Maniak003/HV-voltmeter/README.md

<!DOCTYPE html>
<html lang="en" data-color-mode="auto" data-light-theme="light" data-dark-theme="dark">
  <head>
    <meta charset="utf-8">
  </head>
    <body class="logged-in env-production page-responsive page-blob" style="word-wrap: break-word;">
      <p> Hight voltage (3kV) voltrmeter. </p>
      <a href="https://github.com/Maniak003/HVoltmeter/wiki" rel="nofollow">
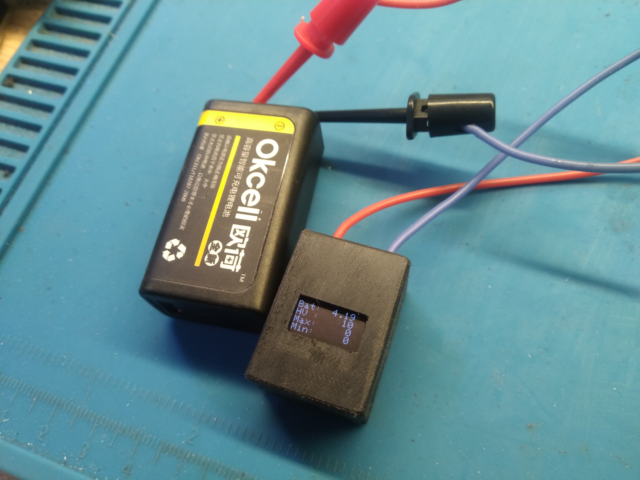
[picture p1: Documents/IMG_20221002_154138.jpg]
        
      </a>
      <a href="https://github.com/Maniak003/HVoltmeter/wiki" rel="nofollow">
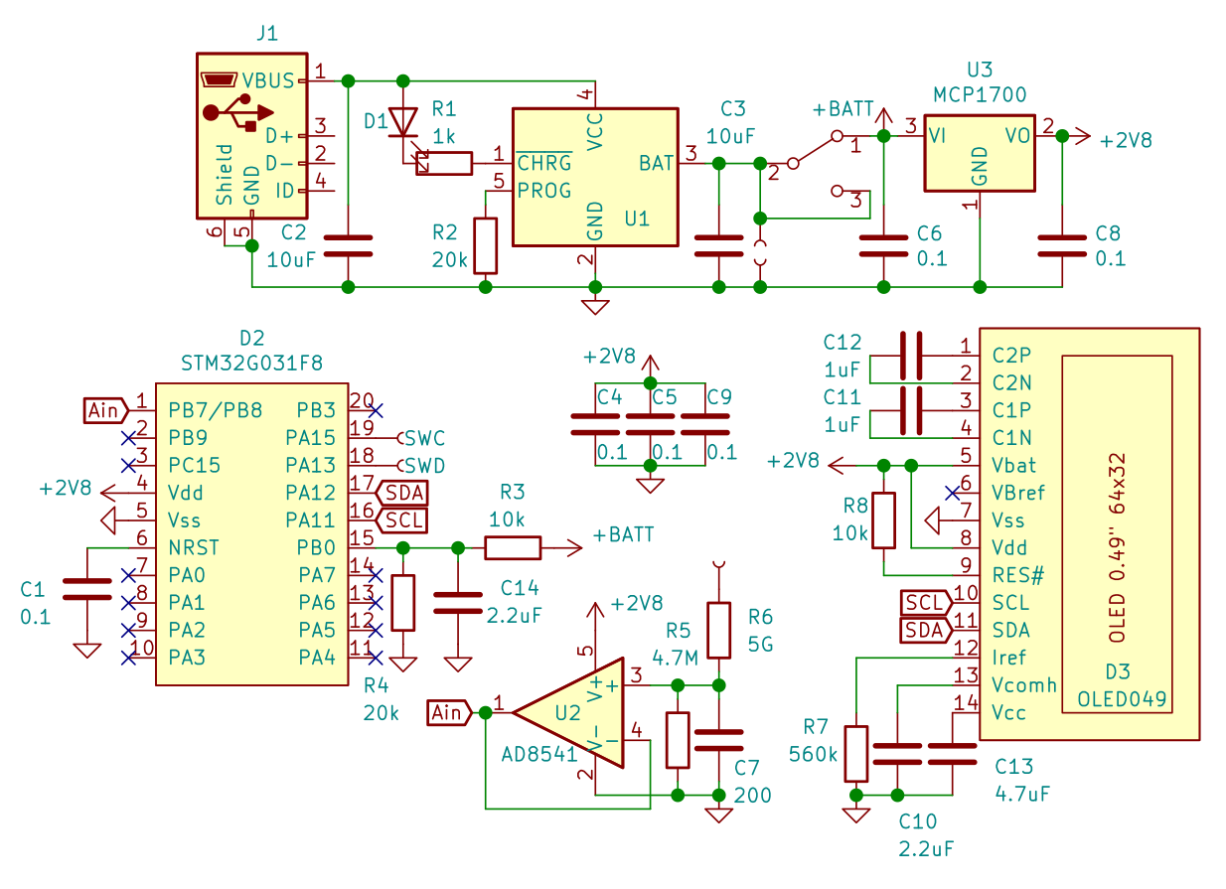
[picture p2: Documents/hvoltmeter.png]
HVoltmeter
        
      </a>
    </body>
</html>
