Maniak003/HV-voltmeter/kicad/hvoltmeter/hvoltmeter.kicad_pcb

## KiCad design kicad/hvoltmeter/hvoltmeter.kicad_pcb (2022-09-29)

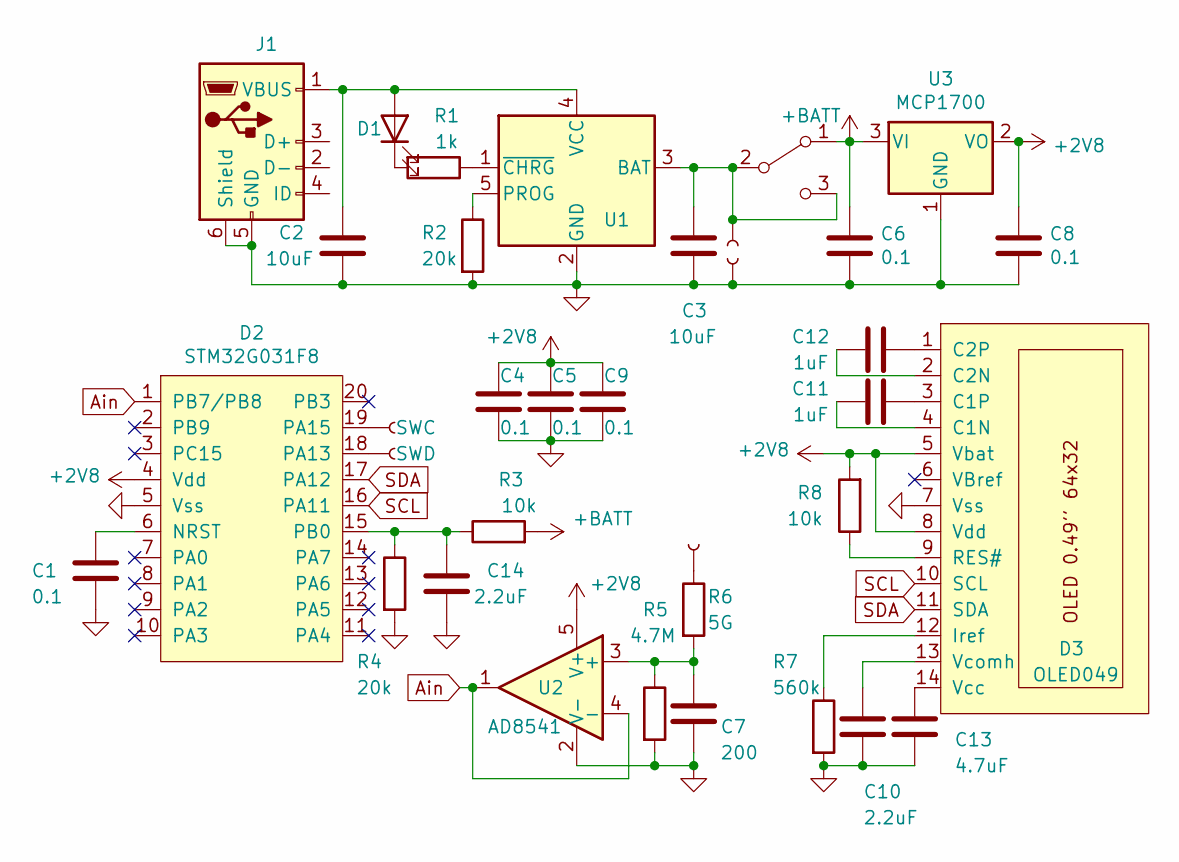
[picture p3: schematic hvoltmeter.sch]

Parts:
C1, C4, C5, C6, C8: 0.1; C_0603_1608Metric
C2, C3: 10uF; C_0603_1608Metric
C7: 200; C_0603_1608Metric
C9: 0.1; C_0402_1005Metric
C10, C14: 2.2uF; C_0402_1005Metric
C11, C12: 1uF; C_0402_1005Metric
C13: 4.7uF; C_0402_1005Metric
D1: LED; LED_0603_1608Metric
D2: STM32G031F8; TSSOP-20_4.4x6.5mm_P0.65mm
D3: OLED049
J1: USB_B_Micro-Connector; USB_Micro-B_Molex_47346-0001
J2: SWC; SMD-CONN
J3: SWD; SMD-CONN
J4, J5, J6: Conn; SMD-CONN
R1: 1k; R_0603_1608Metric
R2, R4: 20k; R_0402_1005Metric
R3, R8: 10k; R_0402_1005Metric
R5: 4.7M; R_0603_1608Metric
R6: 5G; R_2512_6332Metric
R7: 560k; R_0402_1005Metric
SW1: SW_DPDT_x2; MySwithc
U1: LTC4054ES5-4.2; TSOT-23-5
U2: AD8541; TSOT-23-5
U3: MCP1700; SOT-23

Connections:
+2V8: C4.1, C5.1, C8.1, C9.1, D2.4 (Vdd), D3.5 (Vbat), D3.8 (Vdd), R8.2, U2.5 (V+), U3.2 (VO)
+BATT: C6.1, R3.2, SW1.1 (A), U3.3 (VI)
Ain: D2.1 (PB7/PB8), U2.1, U2.4 (-)
GND: C1.2, C2.2, C3.2, C4.2, C5.2, C6.2, C7.2, C8.2, C9.2, C10.1, C13.1, C14.1, D2.5 (Vss), D3.7 (Vss), J1.5 (GND), J1.6 (Shield), J5.1, R2.2, R4.2, R5.2, R7.2, U1.2 (GND), U2.2 (V-), U3.1 (GND)
unnamed: C1.1, D2.6 (NRST)
unnamed: C2.1, D1.2 (A), J1.1 (VBUS), U1.4 (VCC)
unnamed: C3.1, J4.1, SW1.2 (B), SW1.3 (C), U1.3 (BAT)
unnamed: C7.1, R5.1, R6.2, U2.3 (+)
unnamed: C10.2, D3.13 (Vcomh)
unnamed: C11.1, D3.1 (C2P)
unnamed: C11.2, D3.2 (C2N)
unnamed: C12.1, D3.3 (C1P)
unnamed: C12.2, D3.4 (C1N)
unnamed: C13.2, D3.14 (Vcc)
unnamed: C14.2, D2.15 (PB0), R3.1, R4.1
unnamed: D1.1 (K), R1.2
unnamed: D2.18 (PA13), J3.1
unnamed: D2.19 (PA15), J2.1
unnamed: D3.9 (RES#), R8.1
unnamed: D3.12 (Iref), R7.1
unnamed: J6.1, R6.1
unnamed: R1.1, U1.1 (~CHRG)
unnamed: R2.1, U1.5 (PROG)
SCL: D2.16 (PA11), D3.10 (SCL)
SDA: D2.17 (PA12), D3.11 (SDA)

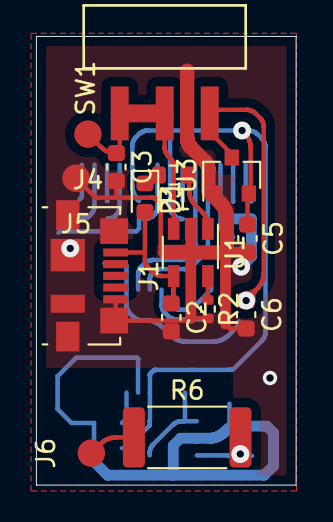
[picture p4: board hvoltmeter.kicad_pcb from above]

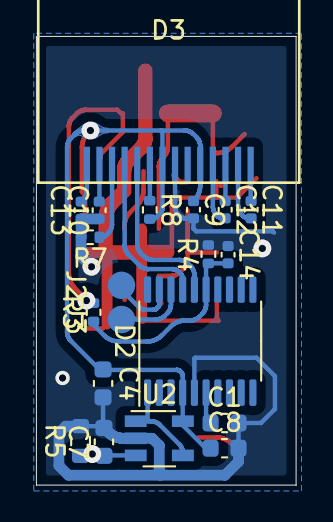
[picture p5: board hvoltmeter.kicad_pcb from below]

Board: 2 copper layers, 14.4 x 24.9 mm, 35 parts (20 on the bottom side), 25 nets.
