Maniak003/HV-voltmeter/STM32Cube/Core/Src/main.c

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
/* Includes ------------------------------------------------------------------*/
#include "main.h"

/* USER CODE BEGIN PM */
char text1306[11];
/* USER CODE END PM */

ADC_HandleTypeDef hadc1;
DMA_HandleTypeDef hdma_adc1;

I2C_HandleTypeDef hi2c2;

TIM_HandleTypeDef htim16;

void SystemClock_Config(void);
static void MX_GPIO_Init(void);
static void MX_DMA_Init(void);
static void MX_I2C2_Init(void);
static void MX_TIM16_Init(void);
static void MX_ADC1_Init(void);
/**
  * @brief  The application entry point.
  * @retval int
  */
int main(void)
{
  /* MCU Configuration--------------------------------------------------------*/

  /* Reset of all peripherals, Initializes the Flash interface and the Systick. */
  HAL_Init();

  /* Configure the system clock */
  SystemClock_Config();

  /* Initialize all configured peripherals */
  MX_GPIO_Init();
  MX_DMA_Init();
  MX_I2C2_Init();
  MX_TIM16_Init();
  MX_ADC1_Init();
  /* USER CODE BEGIN 2 */
  /* ssd1306 init*/
  ssd1306_Init();
  HV = 0;
  LV = 0;
  HAL_TIM_Base_Start_IT(&htim16);
  /* USER CODE END 2 */

  /* Infinite loop */
  /* USER CODE BEGIN WHILE */
  while (1)
  {
	  ssd1306_Fill(Black);
	  ssd1306_SetCursor(0, 0);
	  sprintf(text1306, "Bat:%6.3f", LV);
	  ssd1306_WriteString(text1306, Font_6x8, White);
	  ssd1306_SetCursor(0, 8);
	  sprintf(text1306, "HV : %5.0f", HV);
	  ssd1306_WriteString(text1306, Font_6x8, White);
	  ssd1306_SetCursor(0, 16);
	  sprintf(text1306, "Max: %5.0f", HVmax);
	  ssd1306_WriteString(text1306, Font_6x8, White);
	  ssd1306_SetCursor(0, 24);
	  sprintf(text1306, "Min: %5.0f", HVmin);
	  ssd1306_WriteString(text1306, Font_6x8, White);
	  ssd1306_UpdateScreen();
	  HAL_Delay(100);
    /* USER CODE END WHILE */

    /* USER CODE BEGIN 3 */
  }
  /* USER CODE END 3 */
}

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
/* USER CODE BEGIN 4 */
/*
//void HAL_ADC_ConvCpltCallback(ADC_HandleTypeDef *AdcHandle) {
//void HAL_ADC_ConvHalfCpltCallback(ADC_HandleTypeDef* hadc) {
//void ADC_DMAConvCplt(DMA_HandleTypeDef *hdma) {
	HAL_ADC_Stop_DMA(&hadc1);
	HVolts.HVolt = adcBufer[0];
	LVolts.LVolt = adcBufer[1];
	HVmin++;

}
*/
/* USER CODE END 4 */
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
