Maniak003/HV-voltmeter/STM32Cube/HVoltmeter.ioc

Mcu.UserName=STM32G031F8Px
PB0.GPIO_Label=Batt
PB7.Signal=ADC1_IN11
PB7.GPIO_Label=AIn
PB0.Signal=ADC1_IN8
