Maniak003/HV-voltmeter/STM32Cube/Core/Inc/main.h

#define AIn_Pin GPIO_PIN_7
#define AIn_GPIO_Port GPIOB
#define Batt_Pin GPIO_PIN_0
#define Batt_GPIO_Port GPIOB
