Maniak003/HV-voltmeter/(commit log)

2022-09-23 новый файл: Documents/ER-OLED0.49-1_Series_Datasheet.pdf новый файл: STM32Cube/HV/.cproject новый файл: STM32Cube/HV/.mxproject новый файл: STM32Cube/HV/.project новый файл: STM32Cube/HV/.settings/la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
    [hvoltmeter.kicad_pcb, hvoltmeter.sch]
2022-09-25 удалено: STM32Cube/HV/.cproject удалено: STM32Cube/HV/.mxproject удалено: STM32Cube/HV/.project удалено: STM32Cube/HV/.settings/language.settings.xml удалено: STM32Cube/HV/.settings/stm32cubeide.proj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
    [hvoltmeter.kicad_pcb, hvoltmeter.sch]
2022-09-25 новый файл: STM32Cube/.cproject новый файл: STM32Cube/.mxproject новый файл: STM32Cube/.project новый файл: STM32Cube/.settings/language.settings.xml новый файл: STM32Cube/.settings/stm32cubeide.proj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
2022-09-25 изменено: STM32Cube/.cproject новый файл: STM32Cube/Release/Core/Src/main.d новый файл: STM32Cube/Release/Core/Src/main.o новый файл: STM32Cube/Release/Core/Src/main.su новый файл: STM32Cube/Release/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
2022-09-25 новый файл: kicad/hvoltmeter/hvoltmeter-rescue.dcm новый файл: kicad/hvoltmeter/hvoltmeter-rescue.lib новый файл: kicad/hvoltmeter/sym-lib-table
2022-09-26 изменено: kicad/hvoltmeter/hvoltmeter.kicad_pcb изменено: kicad/hvoltmeter/hvoltmeter.kicad_pcb-bak изменено: kicad/hvoltmeter/hvoltmeter.sch изменено: kicad/hvoltmeter/hvoltmeter.sch-bak
    [hvoltmeter.kicad_pcb, hvoltmeter.sch]
2022-09-26 изменено: STM32Cube/.cproject изменено: STM32Cube/.mxproject изменено: STM32Cube/.project изменено: STM32Cube/.settings/language.settings.xml изменено: STM32Cube/Core/Inc/main.h изменено: STM32Cube/C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
2022-09-26 изменено: STM32Cube/.cproject новый файл: STM32Cube/Release/HVoltmeter.hex изменено: STM32Cube/Release/makefile
2022-09-29 изменено: kicad/hvoltmeter/hvoltmeter.kicad_pcb изменено: kicad/hvoltmeter/hvoltmeter.kicad_pcb-bak
    [hvoltmeter.kicad_pcb]
2022-09-30 новый файл: Documents/hvoltmeter.png изменено: kicad/hvoltmeter/hvoltmeter.pro изменено: kicad/hvoltmeter/hvoltmeter.sch изменено: kicad/hvoltmeter/hvoltmeter.sch-bak
    [hvoltmeter.sch]
2022-10-01 изменено: STM32Cube/.settings/language.settings.xml изменено: STM32Cube/Core/Src/stm32g0xx_it.c изменено: STM32Cube/Release/Core/Src/stm32g0xx_it.o удалено: STM32Cube/Release/HVoltmeter.bin удалено: 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
2022-10-20 новый файл: Documents/IMG_20221002_154138.jpg изменено: STM32Cube/.settings/language.settings.xml
2022-10-20 изменено: README.md
